mtvg/game7sbfwb1/pcb/scoreboard_v1.brd

## EAGLE design pcb/scoreboard_v1.brd (2018-07-24)

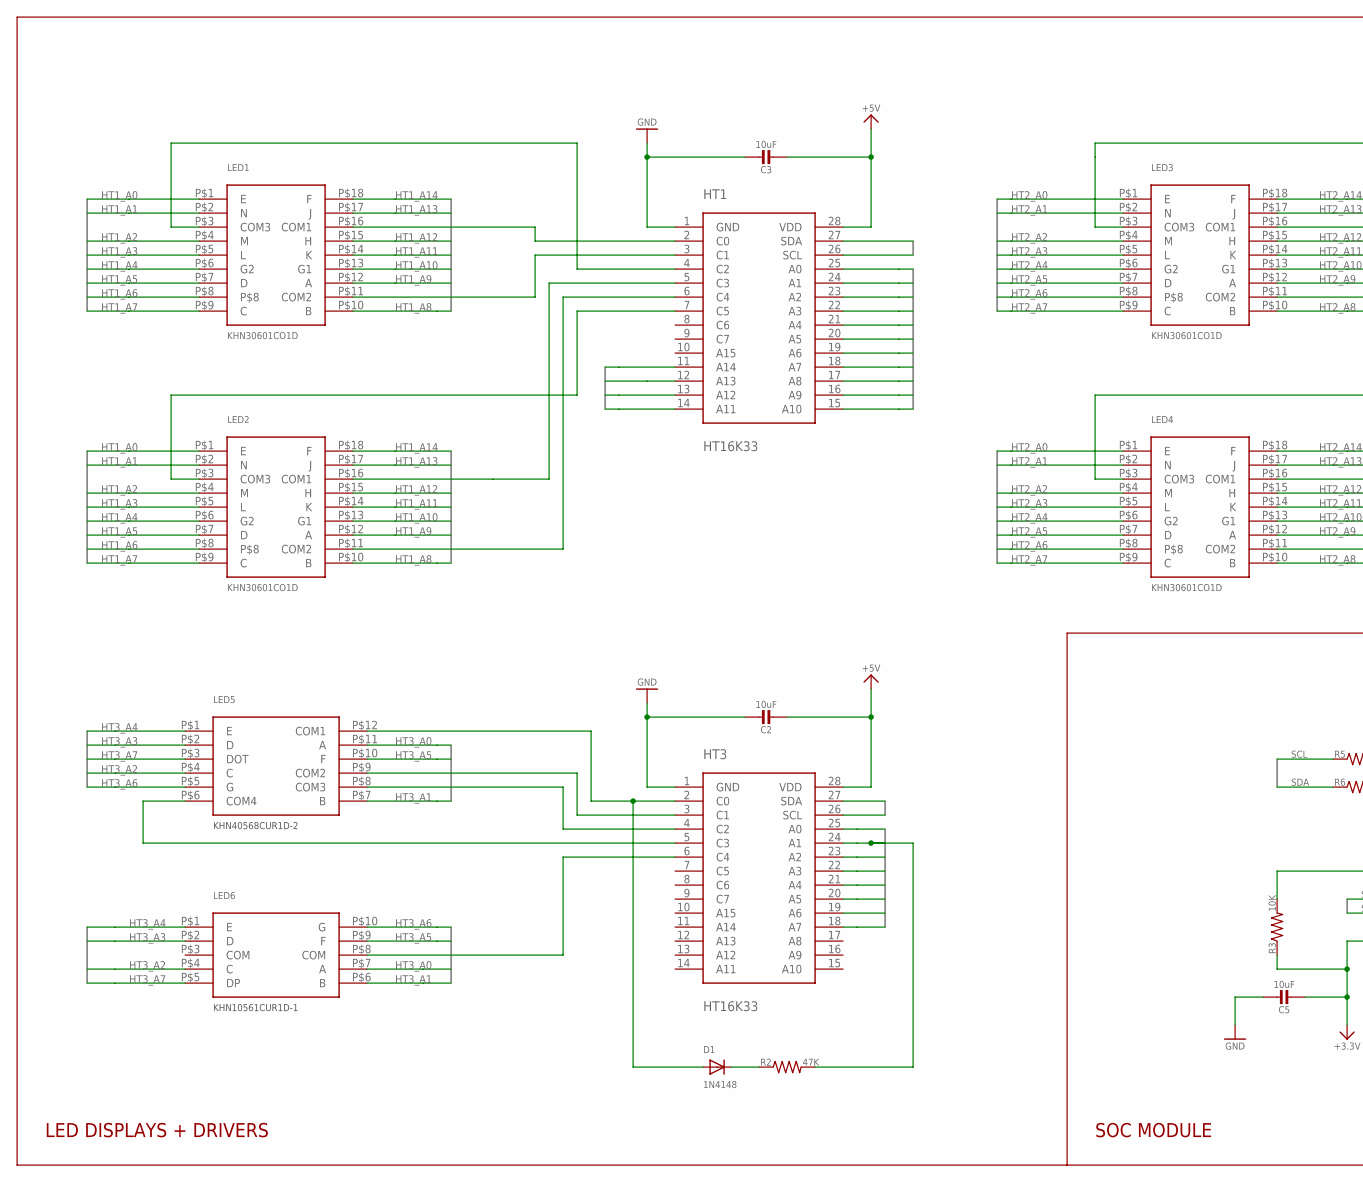
[picture p1: schematic scoreboard_v1.sch, part in row 1, column 1]

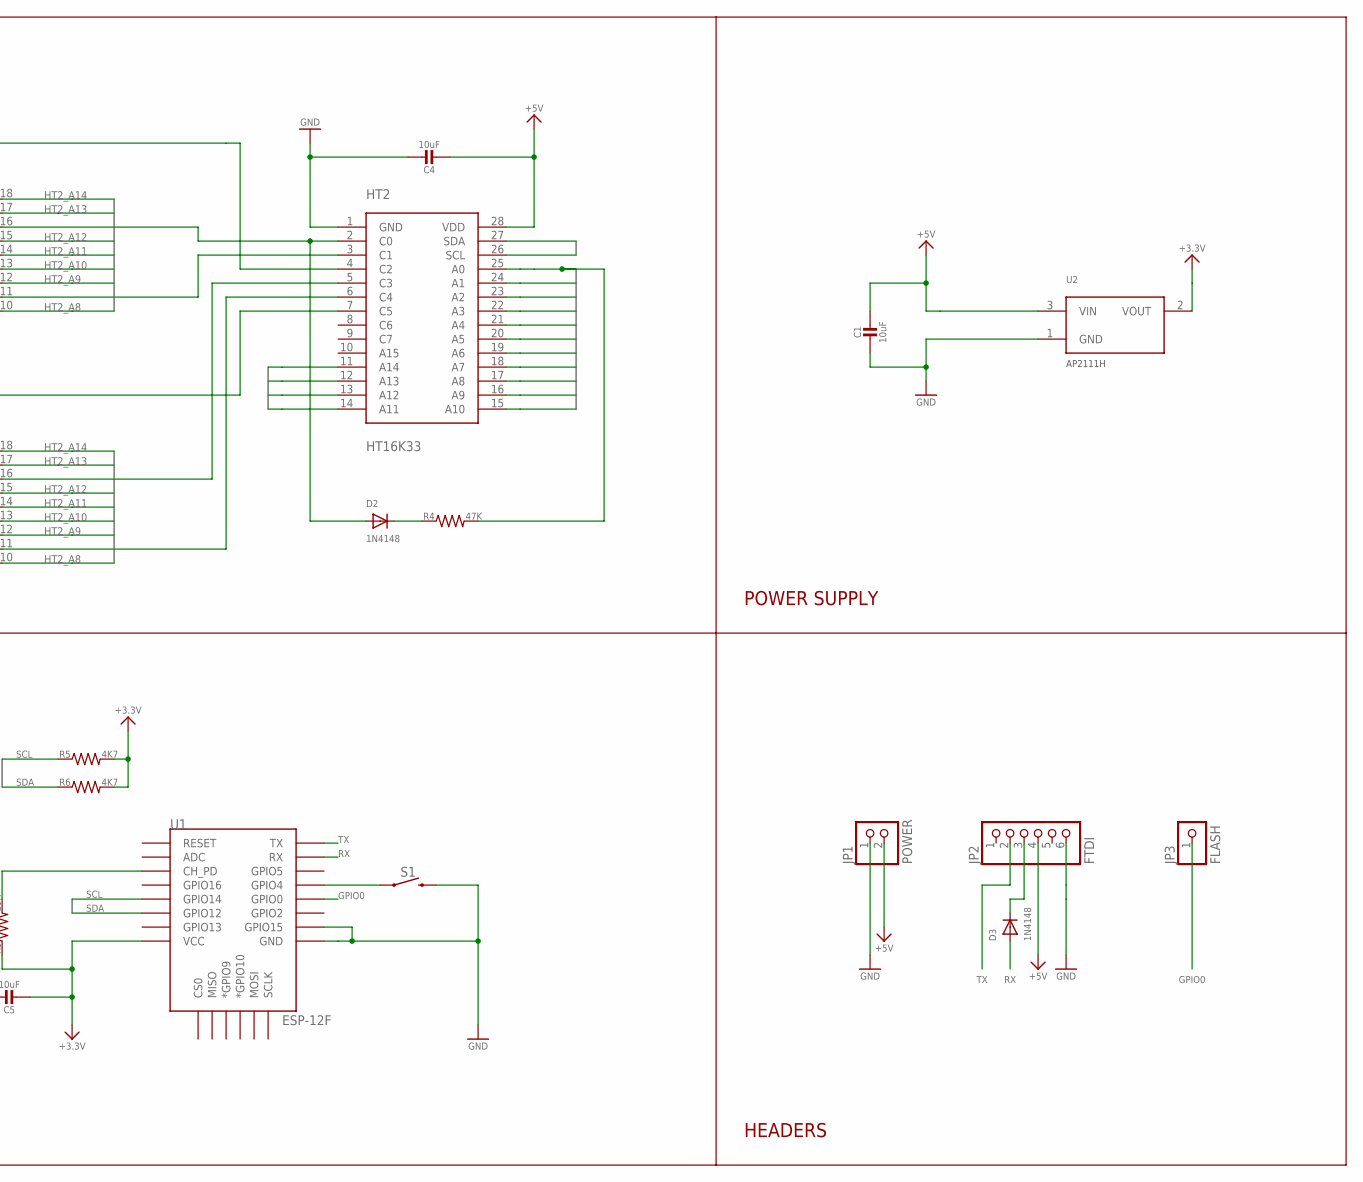
[picture p2: schematic scoreboard_v1.sch, part in row 1, column 2]

Parts:
C1, C2, C3, C4, C5: 10uF; _1206
D1, D2, D3: 1N4148; SOD-123
HT1, HT2, HT3: HT16K33; SOP28
JP1: POWER; 1X02
JP2: FTDI; 1X06
JP3: FLASH; 1X01
LED1, LED2, LED3, LED4: KHN30601CO1D
LED5: KHN40568CUR1D-2
LED6: KHN10561CUR1D-1
R2, R4: 47K; R1206
R3: 10K; R1206
R5, R6: 4K7; R1206
S1: MOMENTARY-SWITCH-SPST-PTH-6.0MM; TACTILE_SWITCH_PTH_6.0MM
U1: ESP-12F; ESP12E-SMD
U2: AP2111H; SOT223

Connections:
3.3V: C5.2, R3.1, R5.2, R6.2, U1.VCC, U2.2 (VOUT)
+5V: C1.1, C2.2, C3.2, C4.2, HT1.28 (VDD), HT2.28 (VDD), HT3.28 (VDD), JP1.2, JP2.4, U2.3 (VIN)
GND: C1.2, C2.1, C3.1, C4.1, C5.1, HT1.1 (GND), HT2.1 (GND), HT3.1 (GND), JP1.1, JP2.6, S1.3 (2), U1.GND, U1.GPIO15, U2.1 (GND)
GPIO0: JP3.1, U1.GPIO0
HT1_A0: HT1.25 (A0), LED1.P$1 (E), LED2.P$1 (E)
HT1_A1: HT1.24 (A1), LED1.P$2 (N), LED2.P$2 (N)
HT1_A2: HT1.23 (A2), LED1.P$4 (M), LED2.P$4 (M)
HT1_A3: HT1.22 (A3), LED1.P$5 (L), LED2.P$5 (L)
HT1_A4: HT1.21 (A4), LED1.P$6 (G2), LED2.P$6 (G2)
HT1_A5: HT1.20 (A5), LED1.P$7 (D), LED2.P$7 (D)
HT1_A6: HT1.19 (A6), LED1.P$8, LED2.P$8
HT1_A7: HT1.18 (A7), LED1.P$9 (C), LED2.P$9 (C)
HT1_A8: HT1.17 (A8), LED1.P$10 (B), LED2.P$10 (B)
HT1_A9: HT1.16 (A9), LED1.P$12 (A), LED2.P$12 (A)
HT1_A10: HT1.15 (A10), LED1.P$13 (G1), LED2.P$13 (G1)
HT1_A11: HT1.14 (A11), LED1.P$14 (K), LED2.P$14 (K)
HT1_A12: HT1.13 (A12), LED1.P$15 (H), LED2.P$15 (H)
HT1_A13: HT1.12 (A13), LED1.P$17 (J), LED2.P$17 (J)
HT1_A14: HT1.11 (A14), LED1.P$18 (F), LED2.P$18 (F)
HT1_C0: HT1.2 (C0), LED1.P$16 (COM1)
HT1_C1: HT1.3 (C1), LED1.P$11 (COM2)
HT1_C2: HT1.4 (C2), LED1.P$3 (COM3)
HT1_C3: HT1.5 (C3), LED2.P$16 (COM1)
HT1_C4: HT1.6 (C4), LED2.P$11 (COM2)
HT1_C5: HT1.7 (C5), LED2.P$3 (COM3)
HT2_A0: HT2.25 (A0), LED3.P$1 (E), LED4.P$1 (E), R4.2
HT2_A1: HT2.24 (A1), LED3.P$2 (N), LED4.P$2 (N)
HT2_A2: HT2.23 (A2), LED3.P$4 (M), LED4.P$4 (M)
HT2_A3: HT2.22 (A3), LED3.P$5 (L), LED4.P$5 (L)
HT2_A4: HT2.21 (A4), LED3.P$6 (G2), LED4.P$6 (G2)
HT2_A5: HT2.20 (A5), LED3.P$7 (D), LED4.P$7 (D)
HT2_A6: HT2.19 (A6), LED3.P$8, LED4.P$8
HT2_A7: HT2.18 (A7), LED3.P$9 (C), LED4.P$9 (C)
HT2_A8: HT2.17 (A8), LED3.P$10 (B), LED4.P$10 (B)
HT2_A9: HT2.16 (A9), LED3.P$12 (A), LED4.P$12 (A)
HT2_A10: HT2.15 (A10), LED3.P$13 (G1), LED4.P$13 (G1)
HT2_A11: HT2.14 (A11), LED3.P$14 (K), LED4.P$14 (K)
HT2_A12: HT2.13 (A12), LED3.P$15 (H), LED4.P$15 (H)
HT2_A13: HT2.12 (A13), LED3.P$17 (J), LED4.P$17 (J)
HT2_A14: HT2.11 (A14), LED3.P$18 (F), LED4.P$18 (F)
HT2_C0: D2.A, HT2.2 (C0), LED3.P$16 (COM1)
HT2_C1: HT2.3 (C1), LED3.P$11 (COM2)
HT2_C2: HT2.4 (C2), LED3.P$3 (COM3)
HT2_C3: HT2.5 (C3), LED4.P$16 (COM1)
HT2_C4: HT2.6 (C4), LED4.P$11 (COM2)
HT2_C5: HT2.7 (C5), LED4.P$3 (COM3)
HT3_A0: HT3.25 (A0), LED5.P$11 (A), LED6.P$7 (A)
HT3_A1: HT3.24 (A1), LED5.P$7 (B), LED6.P$6 (B), R2.2
HT3_A2: HT3.23 (A2), LED5.P$4 (C), LED6.P$4 (C)
HT3_A3: HT3.22 (A3), LED5.P$2 (D), LED6.P$2 (D)
HT3_A4: HT3.21 (A4), LED5.P$1 (E), LED6.P$1 (E)
HT3_A5: HT3.20 (A5), LED5.P$10 (F), LED6.P$9 (F)
HT3_A6: HT3.19 (A6), LED5.P$5 (G), LED6.P$10 (G)
HT3_A7: HT3.18 (A7), LED5.P$3 (DOT), LED6.P$5 (DP)
HT3_C0: D1.A, HT3.2 (C0), LED5.P$12 (COM1)
HT3_C1: HT3.3 (C1), LED5.P$9 (COM2)
HT3_C2: HT3.4 (C2), LED5.P$8 (COM3)
HT3_C3: HT3.5 (C3), LED5.P$6 (COM4)
HT3_C4: HT3.6 (C4), LED6.P$8 (COM)
unnamed: S1.1, U1.GPIO4
unnamed: D3.C, JP2.3
unnamed: D1.C, R2.1
unnamed: R3.2, U1.CH_PD
unnamed: D2.C, R4.1
RX: D3.A, U1.RXD0 (RX)
SCL: HT1.26 (SCL), HT2.26 (SCL), HT3.26 (SCL), R5.1, U1.GPIO14
SDA: HT1.27 (SDA), HT2.27 (SDA), HT3.27 (SDA), R6.1, U1.GPIO12
TX: JP2.2, U1.TXD0 (TX)

Notes on the sheet:
LED DISPLAYS + DRIVERS
POWER SUPPLY
HEADERS
SOC MODULE

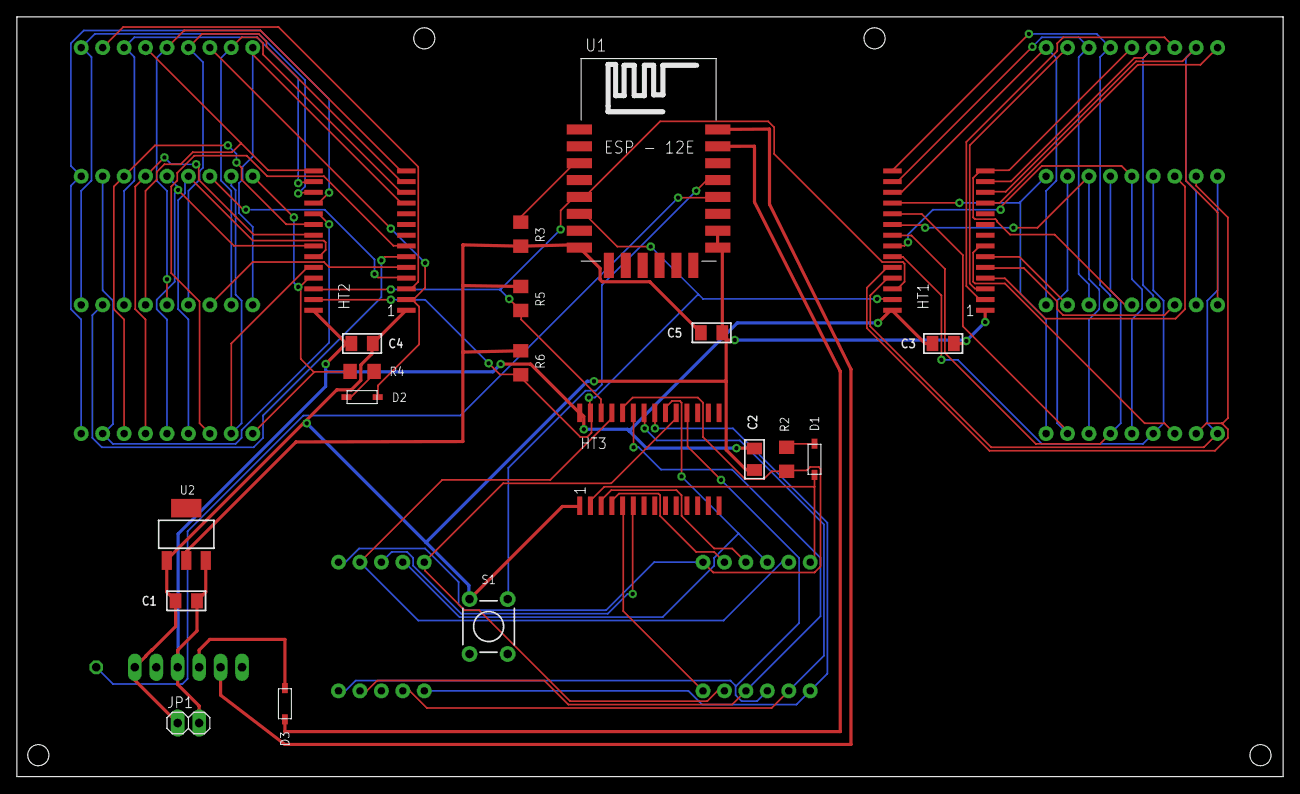
[picture p3: board scoreboard_v1.brd from above]

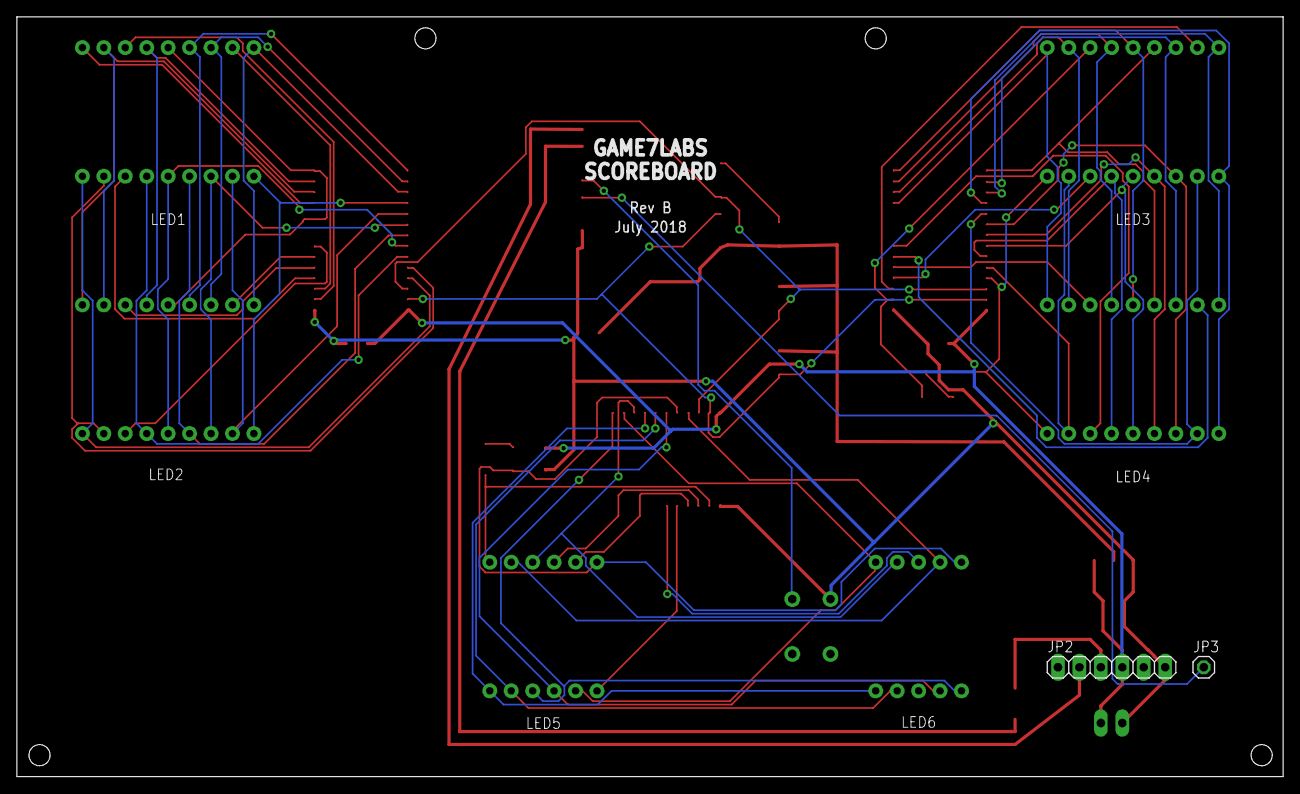
[picture p4: board scoreboard_v1.brd from below]

Board: 2 copper layers, 150.0 x 90.0 mm, 28 parts (8 on the bottom side), 68 nets.
