mtvg/game7sbfwb1/eagle/scoreboard_b2_v3.brd

## EAGLE design eagle/scoreboard_b2_v3.brd (2018-06-02)

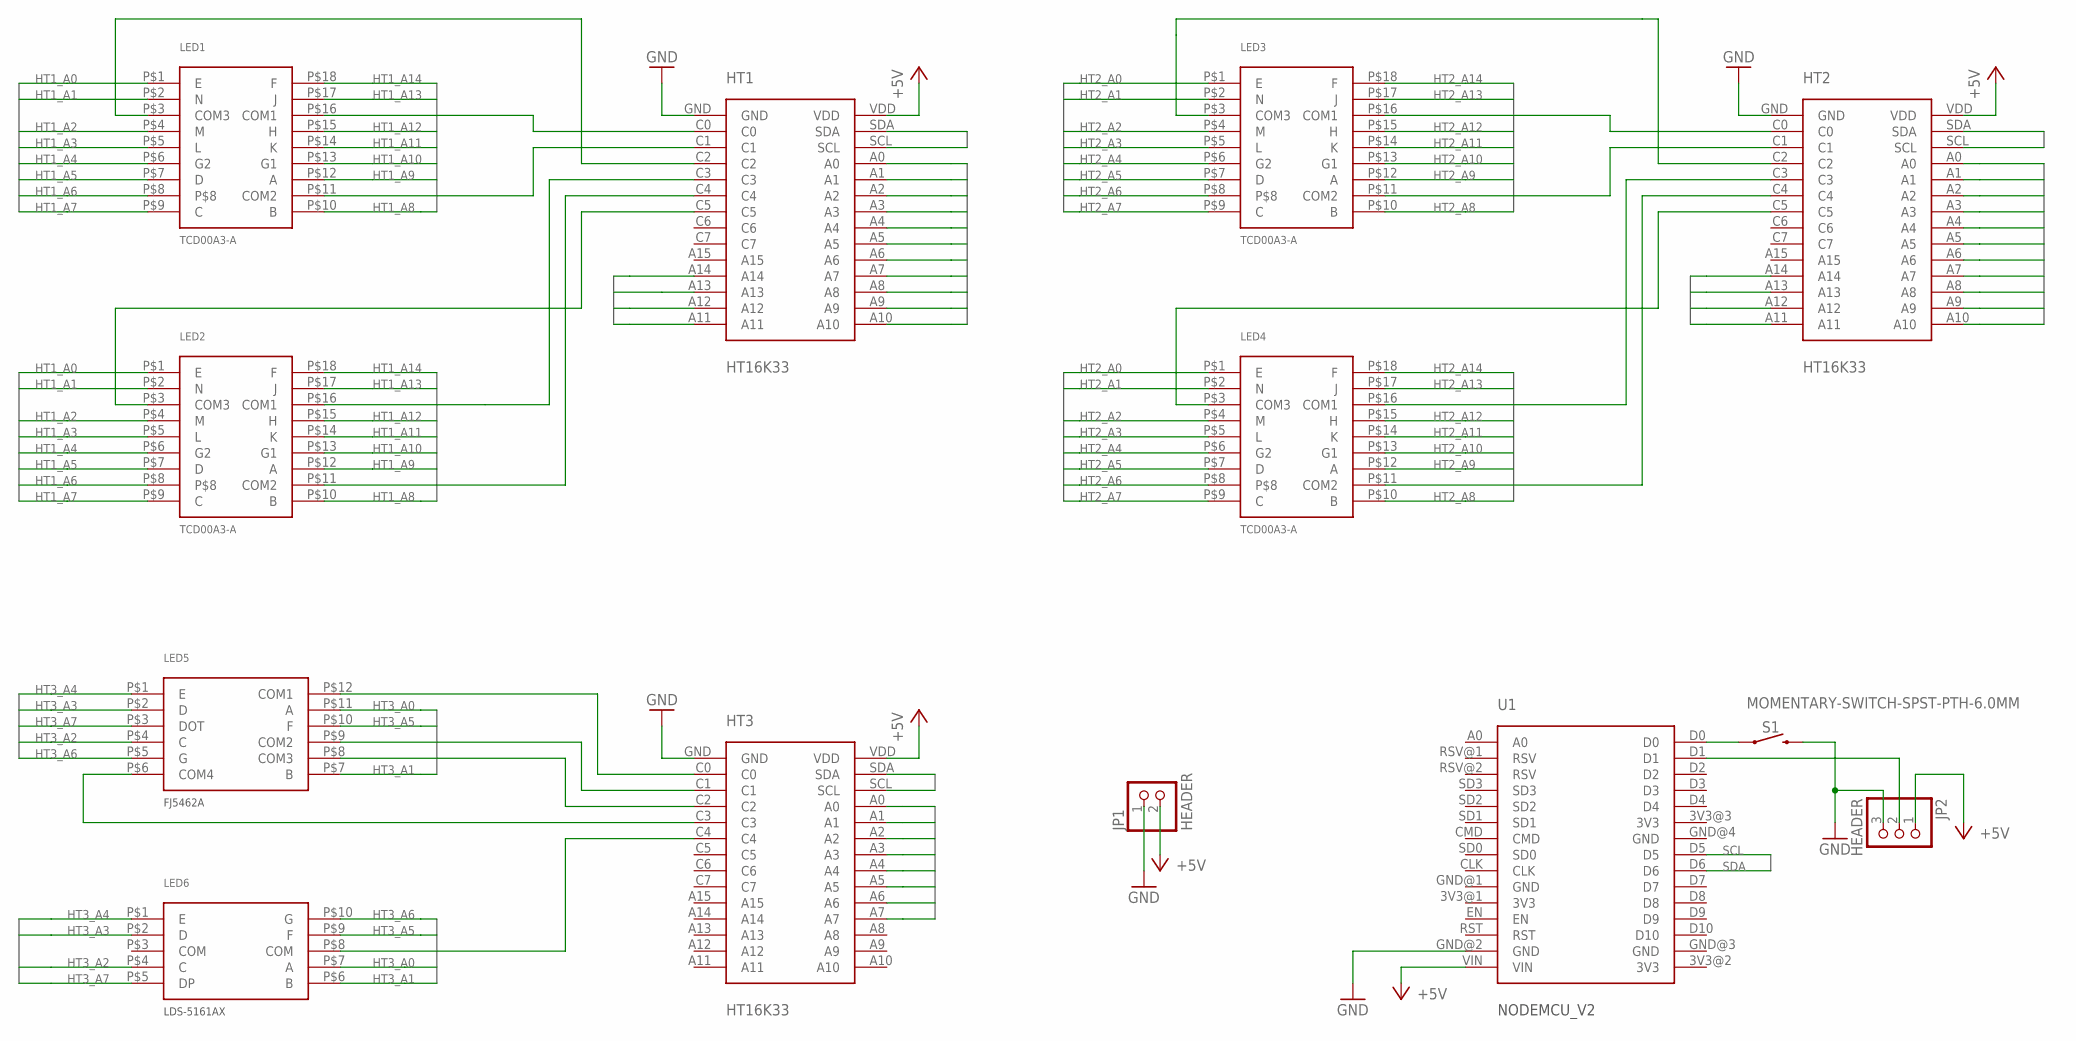
[picture p5: schematic scoreboard_b2_v3.sch]

Parts:
HT1, HT2, HT3: HT16K33
JP1: HEADER; 1X02
JP2: HEADER; 1X03
LED1, LED2, LED3, LED4: TCD00A3-A
LED5: FJ5462A
LED6: LDS-5161AX
S1: MOMENTARY-SWITCH-SPST-PTH-6.0MM; TACTILE_SWITCH_PTH_6.0MM
U1: NODEMCU_V2

Connections:
+5V: HT1.VDD, HT2.VDD, HT3.VDD, JP1.2, JP2.1, U1.VIN
BUZ: JP2.2, U1.D1
GND: HT1.GND, HT2.GND, HT3.GND, JP1.1, JP2.3, S1.3 (2), U1.GND@2 (GND)
HT1_A0: HT1.A0, LED1.P$1 (E), LED2.P$1 (E)
HT1_A1: HT1.A1, LED1.P$2 (N), LED2.P$2 (N)
HT1_A2: HT1.A2, LED1.P$4 (M), LED2.P$4 (M)
HT1_A3: HT1.A3, LED1.P$5 (L), LED2.P$5 (L)
HT1_A4: HT1.A4, LED1.P$6 (G2), LED2.P$6 (G2)
HT1_A5: HT1.A5, LED1.P$7 (D), LED2.P$7 (D)
HT1_A6: HT1.A6, LED1.P$8, LED2.P$8
HT1_A7: HT1.A7, LED1.P$9 (C), LED2.P$9 (C)
HT1_A8: HT1.A8, LED1.P$10 (B), LED2.P$10 (B)
HT1_A9: HT1.A9, LED1.P$12 (A), LED2.P$12 (A)
HT1_A10: HT1.A10, LED1.P$13 (G1), LED2.P$13 (G1)
HT1_A11: HT1.A11, LED1.P$14 (K), LED2.P$14 (K)
HT1_A12: HT1.A12, LED1.P$15 (H), LED2.P$15 (H)
HT1_A13: HT1.A13, LED1.P$17 (J), LED2.P$17 (J)
HT1_A14: HT1.A14, LED1.P$18 (F), LED2.P$18 (F)
HT1_C0: HT1.C0, LED1.P$16 (COM1)
HT1_C1: HT1.C1, LED1.P$11 (COM2)
HT1_C2: HT1.C2, LED1.P$3 (COM3)
HT1_C3: HT1.C3, LED2.P$16 (COM1)
HT1_C4: HT1.C4, LED2.P$11 (COM2)
HT1_C5: HT1.C5, LED2.P$3 (COM3)
HT2_A0: HT2.A0, LED3.P$1 (E), LED4.P$1 (E)
HT2_A1: HT2.A1, LED3.P$2 (N), LED4.P$2 (N)
HT2_A2: HT2.A2, LED3.P$4 (M), LED4.P$4 (M)
HT2_A3: HT2.A3, LED3.P$5 (L), LED4.P$5 (L)
HT2_A4: HT2.A4, LED3.P$6 (G2), LED4.P$6 (G2)
HT2_A5: HT2.A5, LED3.P$7 (D), LED4.P$7 (D)
HT2_A6: HT2.A6, LED3.P$8, LED4.P$8
HT2_A7: HT2.A7, LED3.P$9 (C), LED4.P$9 (C)
HT2_A8: HT2.A8, LED3.P$10 (B), LED4.P$10 (B)
HT2_A9: HT2.A9, LED3.P$12 (A), LED4.P$12 (A)
HT2_A10: HT2.A10, LED3.P$13 (G1), LED4.P$13 (G1)
HT2_A11: HT2.A11, LED3.P$14 (K), LED4.P$14 (K)
HT2_A12: HT2.A12, LED3.P$15 (H), LED4.P$15 (H)
HT2_A13: HT2.A13, LED3.P$17 (J), LED4.P$17 (J)
HT2_A14: HT2.A14, LED3.P$18 (F), LED4.P$18 (F)
HT2_C0: HT2.C0, LED3.P$16 (COM1)
HT2_C1: HT2.C1, LED3.P$11 (COM2)
HT2_C2: HT2.C2, LED3.P$3 (COM3)
HT2_C3: HT2.C3, LED4.P$16 (COM1)
HT2_C4: HT2.C4, LED4.P$11 (COM2)
HT2_C5: HT2.C5, LED4.P$3 (COM3)
HT3_A0: HT3.A0, LED5.P$11 (A), LED6.P$7 (A)
HT3_A1: HT3.A1, LED5.P$7 (B), LED6.P$6 (B)
HT3_A2: HT3.A2, LED5.P$4 (C), LED6.P$4 (C)
HT3_A3: HT3.A3, LED5.P$2 (D), LED6.P$2 (D)
HT3_A4: HT3.A4, LED5.P$1 (E), LED6.P$1 (E)
HT3_A5: HT3.A5, LED5.P$10 (F), LED6.P$9 (F)
HT3_A6: HT3.A6, LED5.P$5 (G), LED6.P$10 (G)
HT3_A7: HT3.A7, LED5.P$3 (DOT), LED6.P$5 (DP)
HT3_C0: HT3.C0, LED5.P$12 (COM1)
HT3_C1: HT3.C1, LED5.P$9 (COM2)
HT3_C2: HT3.C2, LED5.P$8 (COM3)
HT3_C3: HT3.C3, LED5.P$6 (COM4)
HT3_C4: HT3.C4, LED6.P$8 (COM)
SCL: HT1.SCL, HT2.SCL, HT3.SCL, U1.D5
SDA: HT1.SDA, HT2.SDA, HT3.SDA, U1.D6
SW: S1.1, U1.D0

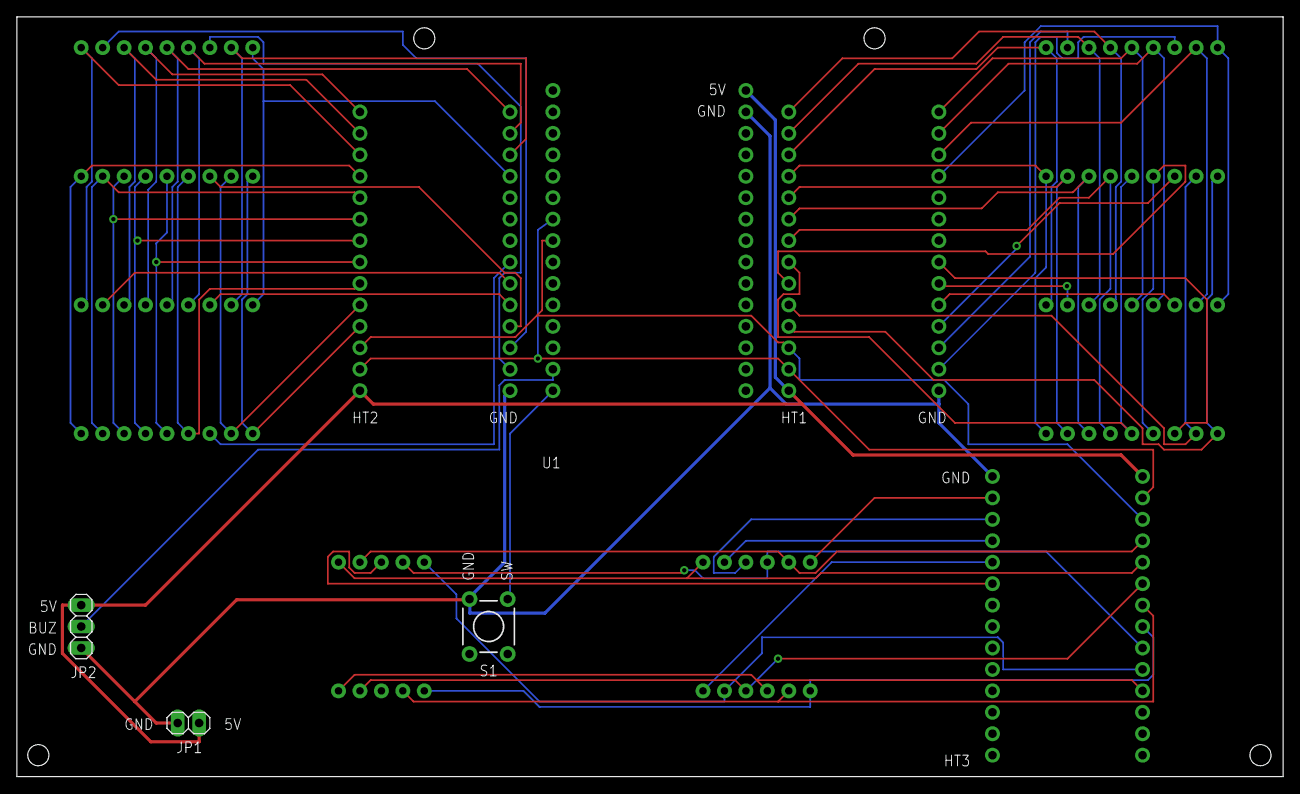
[picture p6: board scoreboard_b2_v3.brd from above]

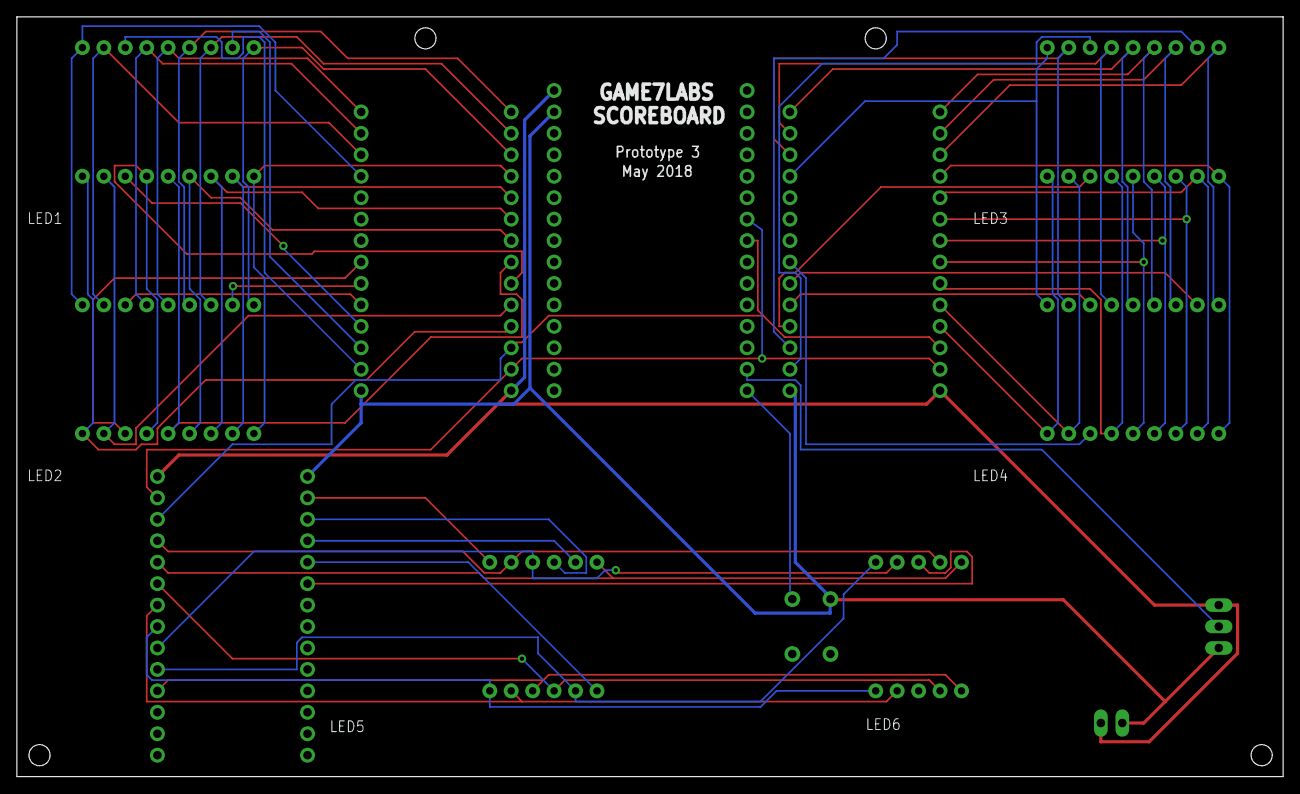
[picture p7: board scoreboard_b2_v3.brd from below]

Board: 2 copper layers, 150.0 x 90.0 mm, 13 parts (6 on the bottom side), 61 nets.
