mtvg/game7sbfwb1/mos/include/game7_display_driver_digits.h

#ifndef G7_DISPLAY_DRIVER_DIGITS_H_
#define G7_DISPLAY_DRIVER_DIGITS_H_

#include <stdint.h>

uint8_t I2C_ADDR[3] = {0x70, 0x71, 0x72};

uint8_t CLOCK_DIGITS[11] = {
//	  .GFEDCBA
	0b01111000, // /(t)
	0b00111111, // 0
	0b00000110, // 1
	0b01011011, // 2
	0b01001111, // 3
	0b01100110, // 4
	0b01101101, // 5
	0b01111101, // 6
	0b00000111, // 7
	0b01111111, // 8
	0b01101111  // 9
};
uint8_t CLOCK_DOT = 0b10000000;

uint16_t ALPHA_DIGITS[10] = {
//	       1     2
//	   FJHKGABC DGLMNE
	0b0100001110100001, // 0
	0b0000000110000000, // 1
	0b0000011100110001, // 2
	0b0000011110110000, // 3
	0b0100010110010000, // 4
	0b0100011010110000, // 5
	0b0100011010110001, // 6
	0b0000001110000000, // 7
	0b0100011110110001, // 8
	0b0100011110110000  // 9
};

uint16_t ALPHA_ALPHAS[26] = {
//	       1     2
//	   FJHKGABC DGLMNE
	0b0100011110010001, // A
	0b0001001110110100, // B
	0b0100001000100001, // C
	0b0001001110100100, // D
	0b0100011000110001, // E
	0b0100011000010001, // F
	0b0100001010110001, // G
	0b0100010110010001, // H
	0b0001001000100100, // I
	0b0000000110100001, // J
	0b0100110000001001, // K
	0b0100000000100001, // L
	0b0110100110000001, // M
	0b0110000110001001, // N
	0b0100001110100001, // O
	0b0100011100010001, // P
	0b0100001110101001, // Q
	0b0100011100011001, // R
	0b0010001010110000, // S
	0b0001001000000100, // T
	0b0100000110100001, // U
	0b0100100000000011, // V
	0b0100000110001011, // W
	0b0010100000001010, // X
	0b0010100000000100, // Y
	0b0000101000100010  // Z
//	   FJHKGABC DGLMNE
//	       1     2
};

#endif /* G7_DISPLAY_DRIVER_DIGITS_H_ */
