mtvg/game7sbfwb1/mos/include/display_digits.h

#ifndef G7_DISPLAY_DIGITS_H_
#define G7_DISPLAY_DIGITS_H_

uint8_t CLOCK_DIGITS[10] = {
//    87654321
	0b11111010, // 0
	0b10000010, // 1
	0b10111001, // 2
	0b10101011, // 3
	0b11000011, // 4
	0b01101011, // 5
	0b01111011, // 6
	0b10100010, // 7
	0b11111011, // 8
	0b11101011  // 9
};
uint8_t CLOCK_DOT = 0b00000100;

uint16_t TEAM_A_DIGITS[10] = {
//    6543210987654321	
	0b1010000110000110, // 0
	0b1000000000000010, // 1
	0b0011000100001110, // 2
	0b1011000000001110, // 3
	0b1001000010001010, // 4
	0b1011000010001100, // 5
	0b1011000110001100, // 6
	0b1000000000000110, // 7
	0b1011000110001110, // 8
	0b1011000010001110  // 9
};

uint16_t TEAM_B_DIGITS[10] = {
//    6543210987654321	
	0b1010010000111000, // 0
	0b1000000000010000, // 1
	0b0011000001111000, // 2
	0b1011000001110000, // 3
	0b1001010001010000, // 4
	0b1011010001100000, // 5
	0b1011010001101000, // 6
	0b1000000000110000, // 7
	0b1011010001111000, // 8
	0b1011010001110000  // 9
};

uint16_t TEAM_A_ALPHAS[26] = {
//    6543210987654321	
	0b1001000110001110, // A
	0b1011010000100110, // B
	0b0010000110000100, // C
	0b1010010000100110, // D
	0b0011000110001100, // E
	0b0001000110001100, // F
	0b1011000110000100, // G
	0b1001000110001010, // H
	0b0010010000100100, // I
	0b1010000100000010, // J
	0b0000100110011000, // K
	0b0010000110000000, // L
	0b1000000111010010, // M
	0b1000100111000010, // N
	0b1010000110000110, // O
	0b0001000110001110, // P
	0b1010100110000110, // Q
	0b0001100110001110, // R
	0b1011000001000100, // S
	0b0000010000100100, // T
	0b1010000110000010, // U
	0b0000001110010000, // V
	0b1000101110000010, // W
	0b0000101001010000, // X
	0b0000010001010000, // Y
	0b0010001000010100  // Z
//    6543210987654321	
};

uint16_t TEAM_B_ALPHAS[26] = {
//    6543210987654321	
	0b1001010001111000, // A
	0b1011000100110010, // B
	0b0010010000101000, // C
	0b1010000100110010, // D
	0b0011010001101000, // E
	0b0001010001101000, // F
	0b1011010000101000, // G
	0b1001010001011000, // H
	0b0010000100100010, // I
	0b1010000000011000, // J
	0b0000110011001000, // K
	0b0010010000001000, // L
	0b1000011010011000, // M
	0b1000111000011000, // N
	0b1010010000111000, // O
	0b0001010001111000, // P
	0b1010110000111000, // Q
	0b0001110001111000, // R
	0b1011001000100000, // S
	0b0000000100100010, // T
	0b1010010000011000, // U
	0b0000010010001100, // V
	0b1000110000011100, // W
	0b0000101010000100, // X
	0b0000001010000010, // Y
	0b0010000010100100  // Z
//    6543210987654321	
};

#endif /* G7_DISPLAY_DIGITS_H_ */
