mtvg/game7sbfwb1/(commit log)

2018-05-09 Firmware driver complete + swift example
2018-05-14 adding blink + buzzer
    [game7_display_driver.c, game7_display_driver.h, game7_display_driver_digits.h, main.c]
2018-06-02 Firmware update for prototype v3
    [scoreboard_b2_v3.brd, scoreboard_b2_v3.sch]
2018-06-02 led driver fw tab fix
    [game7_display_driver_digits.h]
2018-06-08 PWM fix
2018-07-05 Eagle files added
    [scoreboard_b2.sch, scoreboard_b2_v2.sch, scoreboard_b2_v3.brd, scoreboard_b2_v3.sch, scoreboard_proto.sch]
2018-07-22 Scoreboard PCB SMD
    [scoreboard_v1.brd, scoreboard_v1.sch]
2018-07-24 PCB update for SMD version
    [scoreboard_v1.brd, scoreboard_v1.sch]
